adamjvr/WPI_WAVE_Thruster_Controller/(list of files, drawings)

Other design files:
Breakout to AHD Shield.SchDoc
Motor and Power IO.SchDoc
Pair 1.SchDoc
Pair 2.SchDoc
Pair 3.SchDoc
Thruster Driver Board.PcbDoc
Thruster Shield.SchDoc
