adamjvr/WPI_WAVE_Thruster_Controller/(commit log)

2013-03-06 Design FIles Added
    Altium Design files and smart PDF added
    [Breakout to AHD Shield.SchDoc, Motor and Power IO.SchDoc, Pair 1.SchDoc, Pair 2.SchDoc, Pair 3.SchDoc, Thruster Driver Board.PcbDoc, Thruster Shield.SchDoc]
2013-03-20 Ground and Thermal Relief Modification
    Ground and thermal relief pads for VNH5019 properly added in the PCB
    layout.
    [Thruster Driver Board.PcbDoc]
2013-03-25 Thermal relief pads for the VNH5019 H-bridge ICs are now attached to the interal ground plane. This should ensure stable operation and propper thermal relief.
    [Motor and Power IO.SchDoc]
